LenShustek/RedLINK-Sniffer/spi_sniffer.JPG

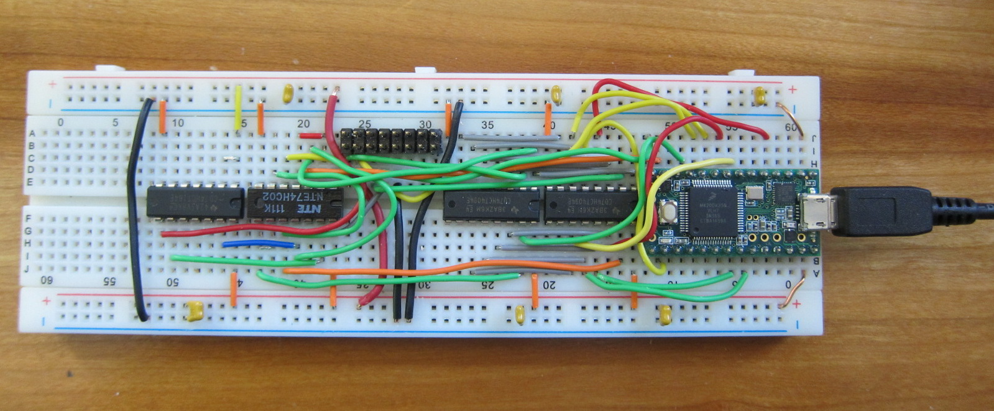
spi_sniffer.JPG
