LenShustek/RedLINK-Sniffer/(threads)

Thread 1 (2016-11-04):

Status updates?

UnitedMarsupials, 2016-11-04:
Hello! I've installed two RedLink sensors recently, both communicating to a new thermostat. I'd love to be able to log the sensors' readings on my computer (running FreeBSD), but the only "official" way to do that is to buy a [RedLink "gateway"](https://www.amazon.com/Honeywell-THM6000R1002-Enabled-Internet-Gateway/dp/B006BD1K4A) (which would've been fine) and then download the readings from Honeywell's web-site. That latter part annoys me to no end -- Honeywell needn't know the temperatures in my house...

Searching the Internet for "Redlink sniff" brought me here. What is the status of your project?

Is there a hardware I can already buy, which, connected to a computer's port (COM, USB?) would allow some software to read the data, that sensors are sending to the thermostat? I'm a software guy, so any modifications to hardware would have to be very well enumerated and clearly spelled-out :-)

Alternatively, have you considered intercepting not the radio-signals, but the TCP-packets, that their "gateway" sends to Honeywell? Folks trying to hack AcuRite bridge seem to have made [some progress](http://moderntoil.com/?p=794) with that approach.

LenShustek, 2016-11-04:
Unfortunately I was not able to make progress on reverse-engineering the RedLINK wireless communication, so I abandoned this project. I actually ripped out all my RedLINK equipment (!) and implemented an entirely different approach to solve my particular problem by building custom wireless sensors. If you're curious, see https://github.com/LenShustek/tempsensor.

I had tried briefly to look at the TCP packets that the RedLINK gateway sends, but I couldn't get around the encryption. Someone more knowledgeable about modern protocols might be able to do better at that.

Good luck!

Closed 2017-06-05.

Thread 2 (2017-12-28):

I'm interested in picking this up

toftat, 2017-12-28:
I am on the verge of getting some redlink devices and would like to bring them into my home automation setup, in the process of which I came across this stuff.

I have an EZ-430 chronos (see here http://processors.wiki.ti.com/index.php/EZ430-Chronos) which comes with a USB based CC1111 (or CC1101) device that I might repurpose  to manage the communications with the redlink network.

I will need to figure out how to get code onto the device and see what I can make it do, but I suspect that I will be able to get the RF aspects into the microcontroller firmware and provide  a simple text based output.

To you have any advise beyond what is here?

LenShustek, 2017-12-29:
My frustration was such that I decommissioned all of my RedLINK gear a couple of years ago and replaced it with wireless thermostats that I designed and built myself: https://github.com/LenShustek/tempsensor.
So unfortunately I don't have any more recent information or advice about reverse-engineering RedLINK.  But out of intellectual curiosity I would be very interested in what you learn! I'd especially like to understand how the receiver synchronizes with multiple transmit-only sensors that are communicating by frequency-hopping.

toftat, 2018-01-02:
Thanks for the update!

Unfortunately I am fighting a significant WAF problem, so if it's visible it has to look store bought, and it has to work right out of the box. So building and installing my own stuff is a challenge. However if I can install the system and then interpret the data I can do stuff with it.

If _I_ was designing the frequency hopping I would make each transmitted packet the largest it could be, while at the same time fitting into one hop. Then when the time came to send the packet, I would transmit it on the current channel, then hop and retransmit a few times. On the receiver it would hop as fast as possible, listening to each channel. Once it saw a channel in use, it would hop once more and wait for a while. This way when the transmitter does a hop and retransmit cycle, it would transmit on the channel the receiver is now listening to. Once the receiver gets the packet (or has a timeout), it would then return to scanning.

After the transmitter sent it, it would choose another channel at random and when the time came for the next transmit start the process again.

I would make the next channel and next transmit time be random so that if 2 sensors stepped on each other on _this_ reading they'd be highly unlikely to do it again on the next reading. As long as the frequency of readings are reasonable (2-3 minutes or less between for example) the user won't notice if they occasionally got lost.

Again, that's how I'd do it, not saying anything about how redlink does it.

laynd, 2020-11-02:
@toftat Any success in your efforts? I got Mitsubishi HVAC system with Redlink adapters. Wondering if anyone had any success with Redlink to Bacnet translation. There is a Redlink to web adapter by Honeywell but I assume it will require a good deal of reverse engineering to get useful data

toftat, 2020-11-02:
No, I decided that I was not going to dig into this, and explored designing and building my own controller and thermostats, it turns out that the traditional controller is very basic, and emulating it is relatively simple, a handful of relays is all you need, the smarts are important when deciding which relays to close when.

As I was researching this, I came across the Ecobee line that did what I wanted out of the box so I went with that product.

KTibow, 2023-03-25:
I'm also interested in this. I want to set something up for some of my family members but they don't want me to connect anything to the thermostat or unit, so connecting wirelessly seems like the only option.
