LenShustek/RedLINK-Sniffer/spi_sniffer.pdf

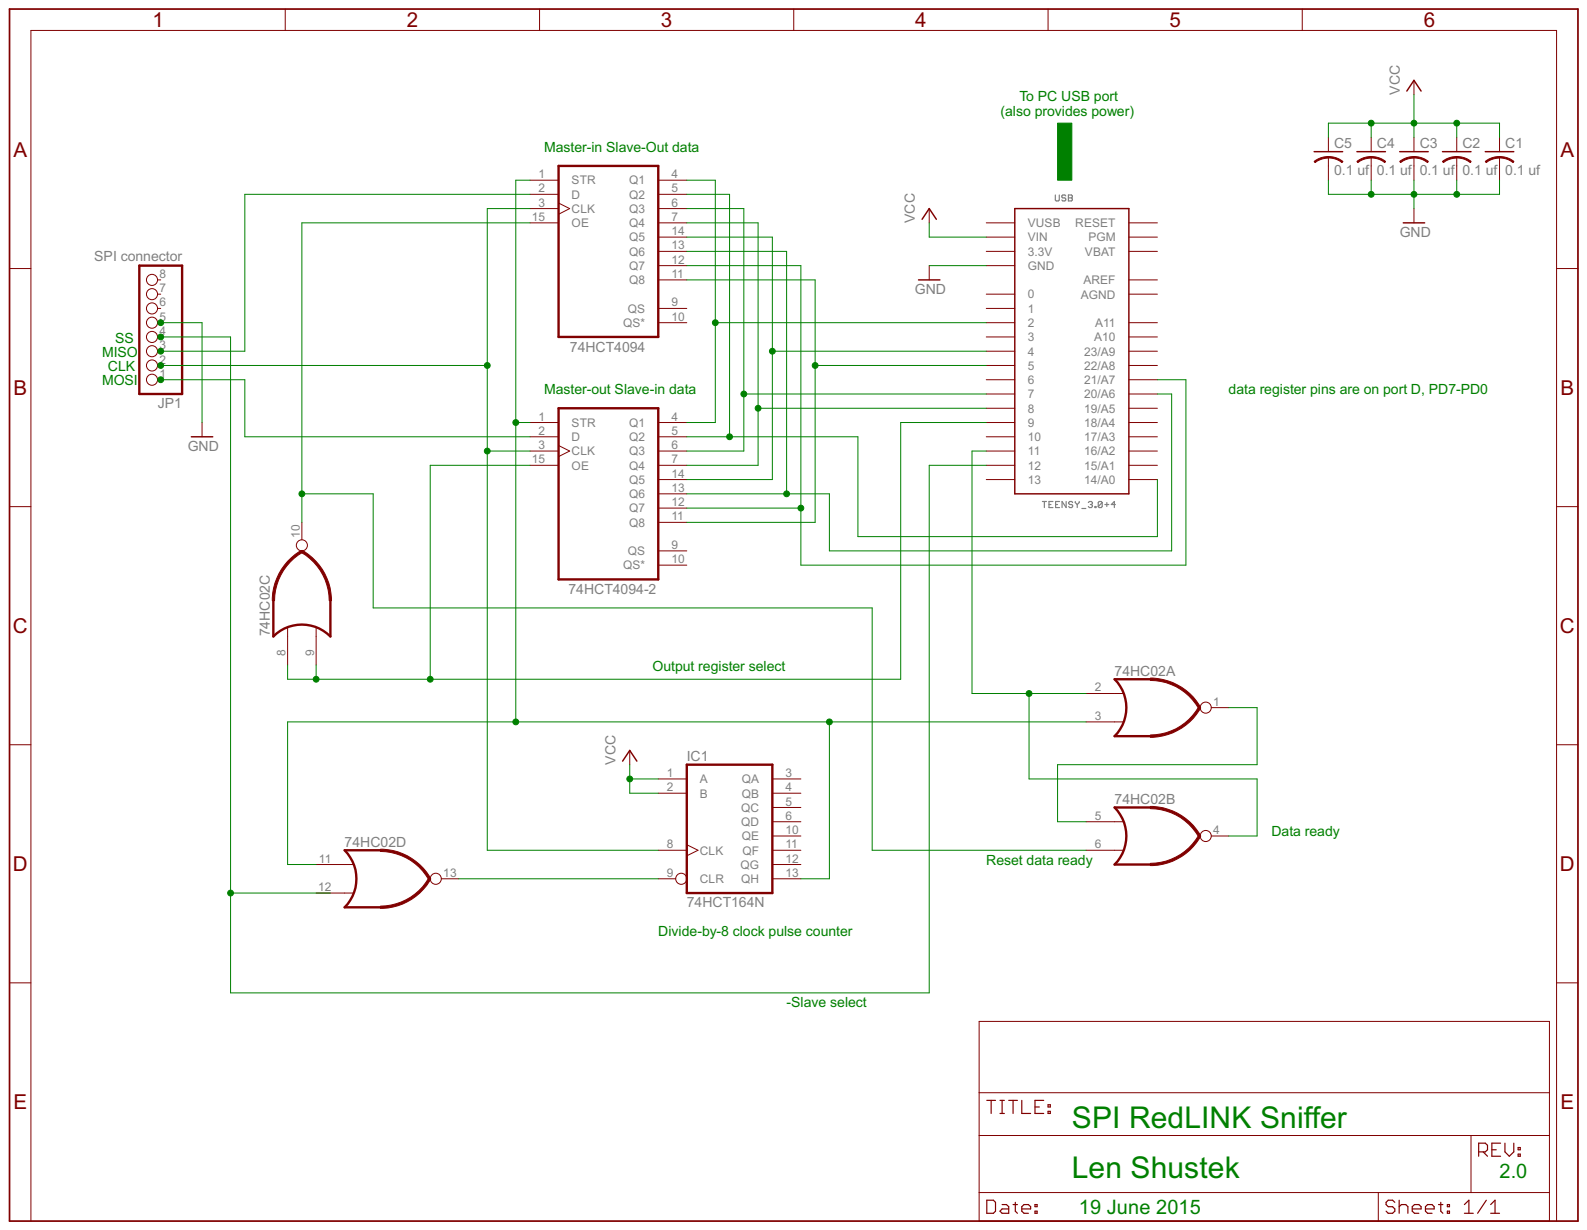
[picture p3: page 1]

To PC USB port
(also provides power)

Master-in Slave-Out data

data register pins are on port D, PD7-PD0

Divide-by-8 clock pulse counter
