LenShustek/RedLINK-Sniffer/(commit log)

2015-05-05 example sniffed SPI datastream
2015-05-05 example SPI datastream decoded
2015-05-05 photo of my SPI sniffer
2015-05-05 Arduino sniffer code
2015-05-05 PC program to decode SPI bytestream
2015-05-06 schematic of SPI RedLINK Sniffer
2015-05-07 schematic of my RedLINK SPI Sniffer
2015-06-23 PC program to decode SPI bytestream for the TI RF transceiver
2015-06-23 photo of version 2 of my SPI Sniffer
2015-06-23 schematic of version 2 of my SPI Sniffer
2015-06-23 SPI Sniffer code for Teensy microcontroller
2015-11-06 SPI Sniffer code for the Teensy microcontroller
2015-11-06 Examples sniffed traces of RedLINK transciever communications
2015-11-06 PC program to decode the SPI bytestream for the TI RF transceiver used by RedLINK
