LenShustek/RedLINK-Sniffer/(notices)

Notices in the files:
spi_decode_01.c:
This program is free software: you can redistribute it and/or modify
it under the terms of version 3 of the GNU General Public License as
published by the Free Software Foundation at http://www.gnu.org/licenses,
with Additional Permissions under term 7(b) that the original copyright
